schneider42/uberbus/hardware/media/alarm-innen.jpg

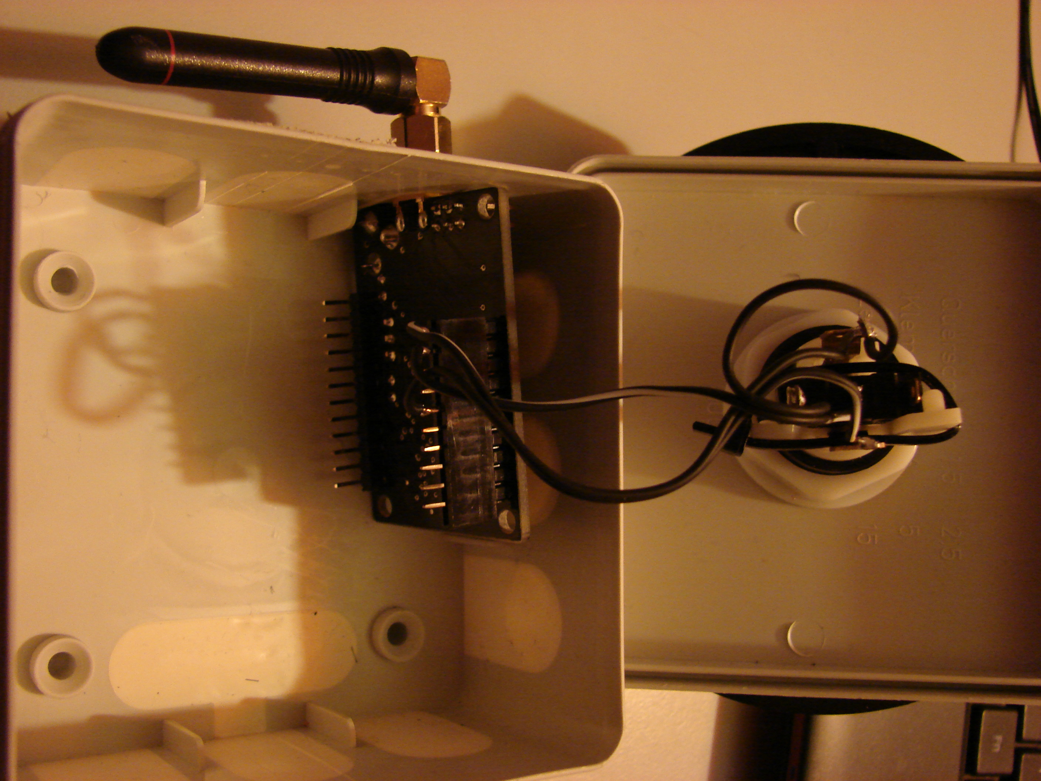
hardware/media/alarm-innen.jpg
