schneider42/uberbus/hardware/media/dev-rf-ecke.jpg

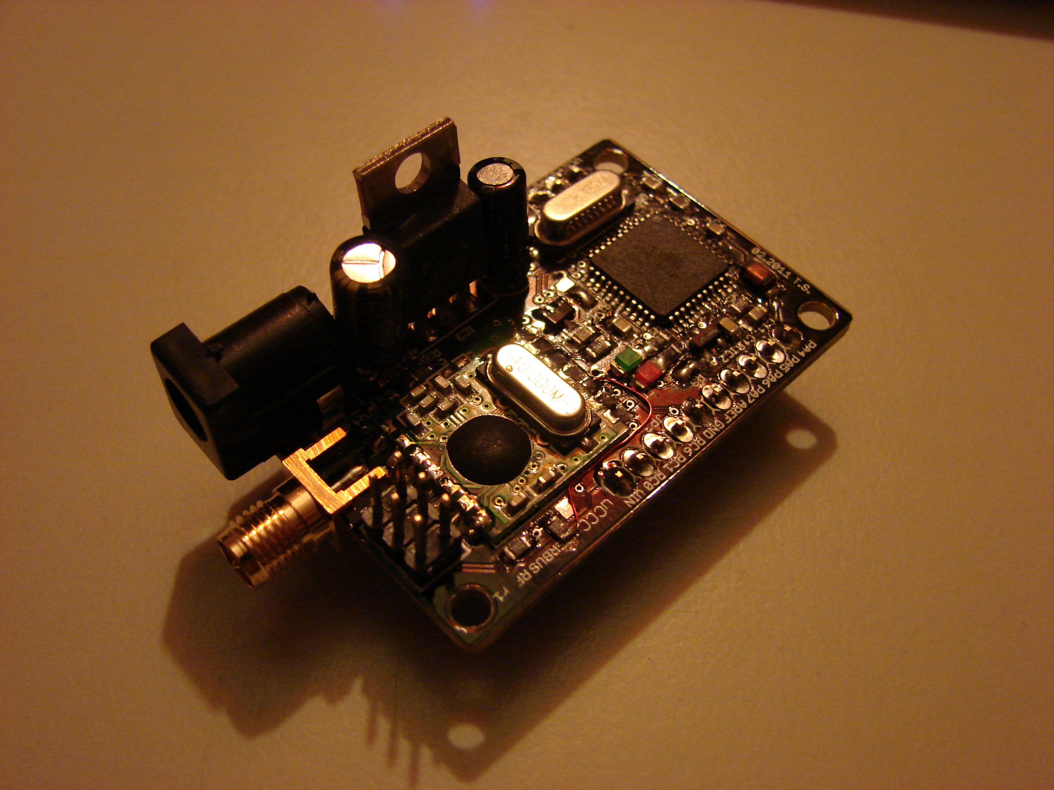
hardware/media/dev-rf-ecke.jpg
