schneider42/uberbus/software/pythonlib/doc/index.rst

.. uberbus python library documentation master file, created by
   sphinx-quickstart on Fri Mar 18 02:42:10 2011.
   You can adapt this file completely to your liking, but it should at least
   contain the root `toctree` directive.

Welcome to uberbus python library's documentation!
==================================================

Contents:

.. toctree::
   :maxdepth: 2

.. automodule:: uberbus.moodlamp

.. autoclass:: Moodlamp
          :members:

.. automodule:: uberbus.ubnode

.. autoclass:: UBNode
          :members: 

Indices and tables
==================

* :ref:`genindex`
* :ref:`modindex`
* :ref:`search`
