schneider42/uberbus/hardware/devboard/devboard-rf-brd.png

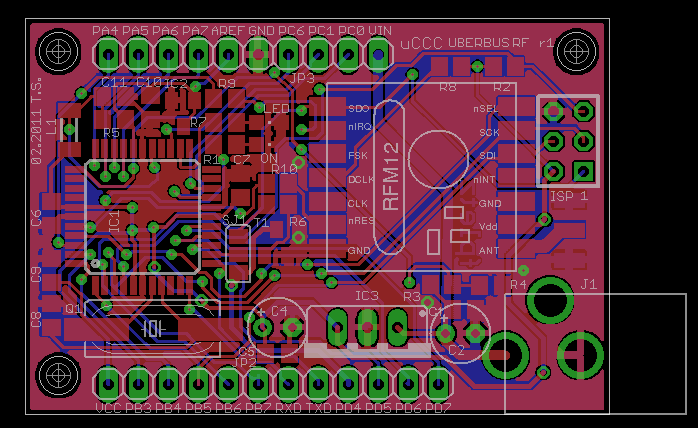
hardware/devboard/devboard-rf-brd.png
