schneider42/uberbus/hardware/devboard/devboard-rs485-brd.png

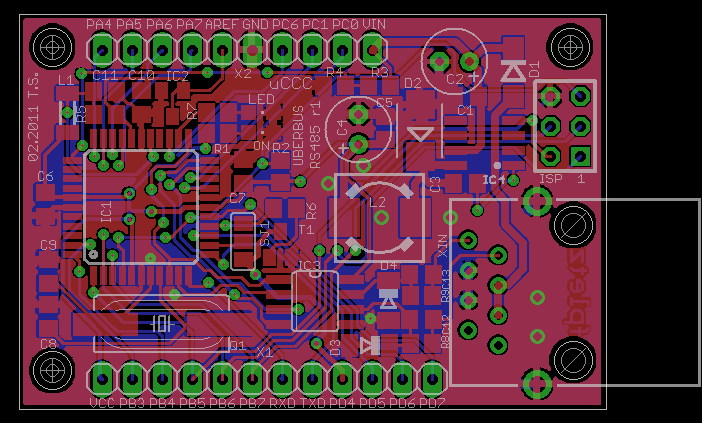
hardware/devboard/devboard-rs485-brd.png
