schneider42/uberbus/hardware/media/alarm.jpg

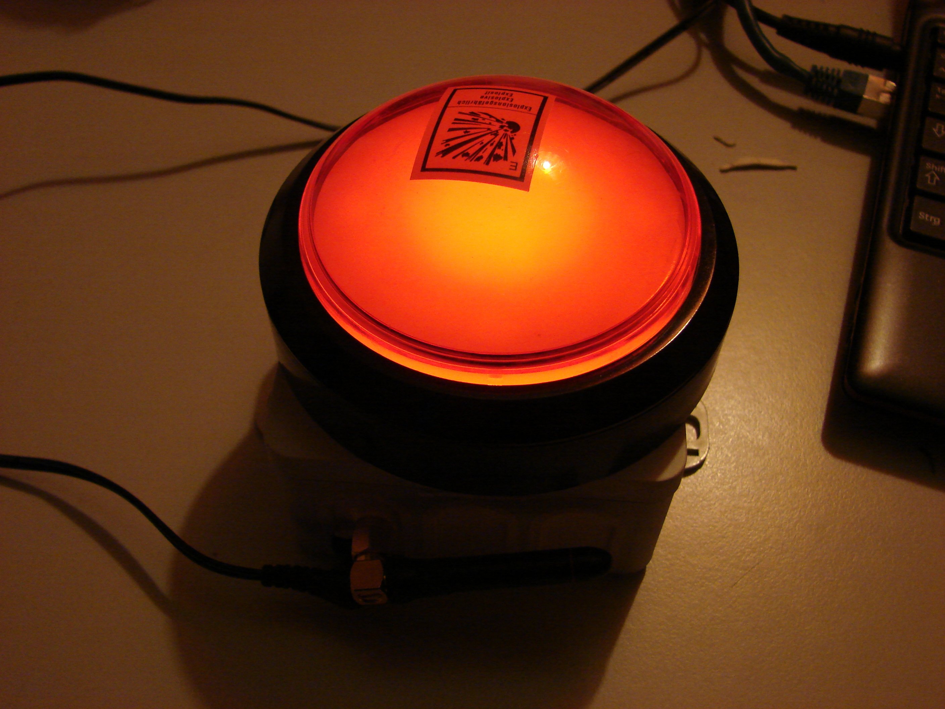
hardware/media/alarm.jpg
