schneider42/uberbus/hardware/media/dev-rf-2.jpg

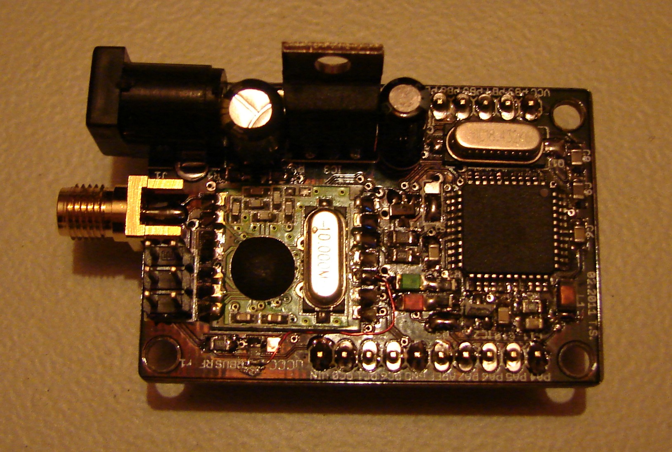
hardware/media/dev-rf-2.jpg
