schneider42/uberbus/hardware/media/dev-rf-ecke-ant.jpg

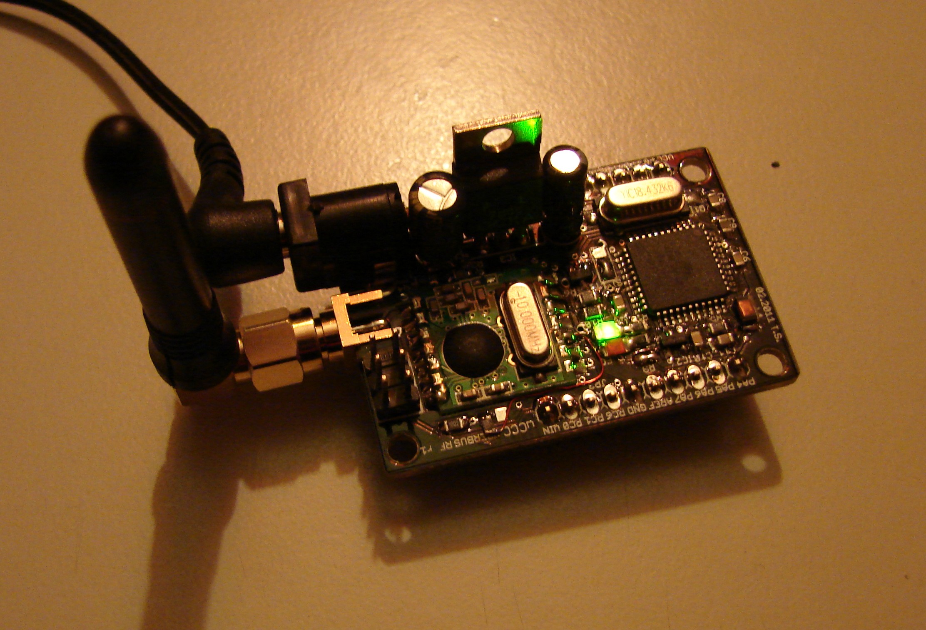
hardware/media/dev-rf-ecke-ant.jpg
