schneider42/uberbus/hardware/media/dev-rf-ecke-unten.jpg

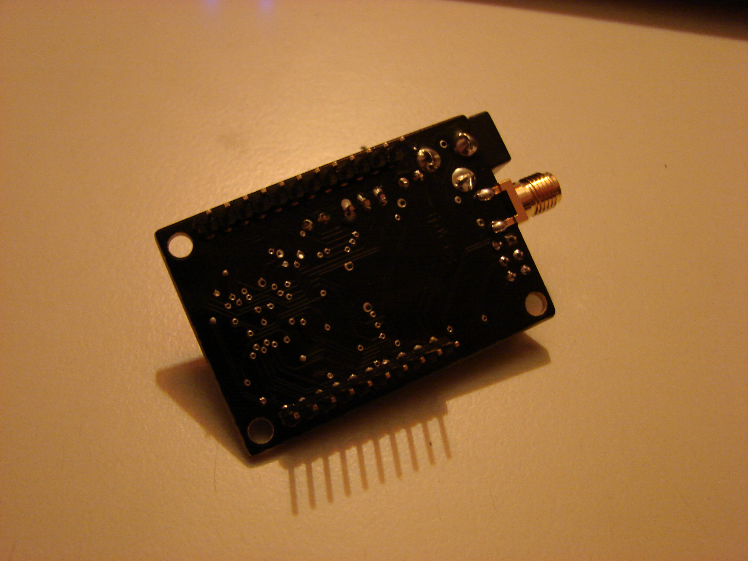
hardware/media/dev-rf-ecke-unten.jpg
