schneider42/uberbus/hardware/media/dev-rf-ml.jpg

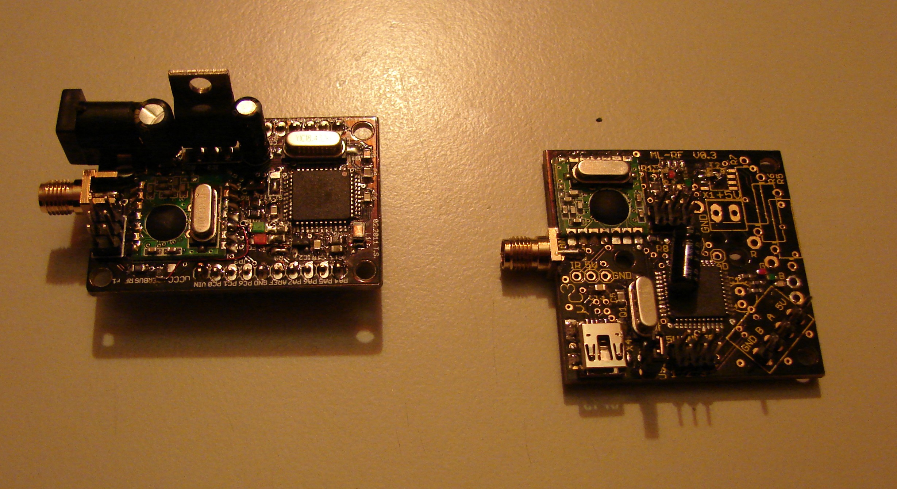
hardware/media/dev-rf-ml.jpg
