schneider42/uberbus/hardware/media/dev-rf.jpg

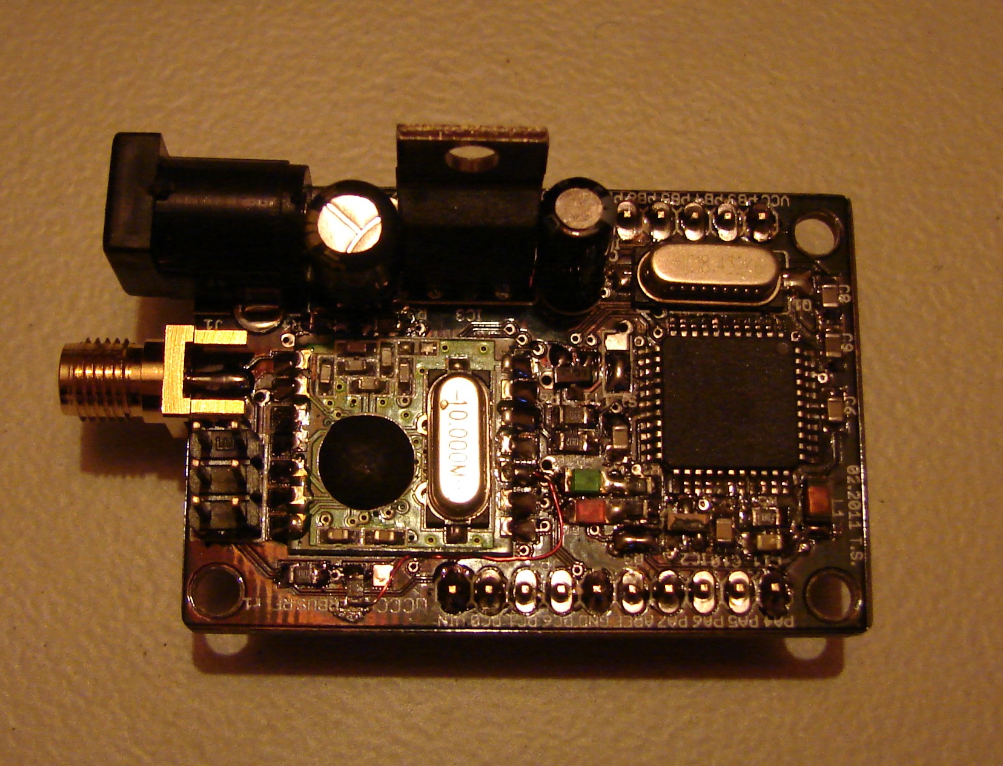
hardware/media/dev-rf.jpg
