schneider42/uberbus/hardware/media/rgb/IMG_20110629_131019.jpg

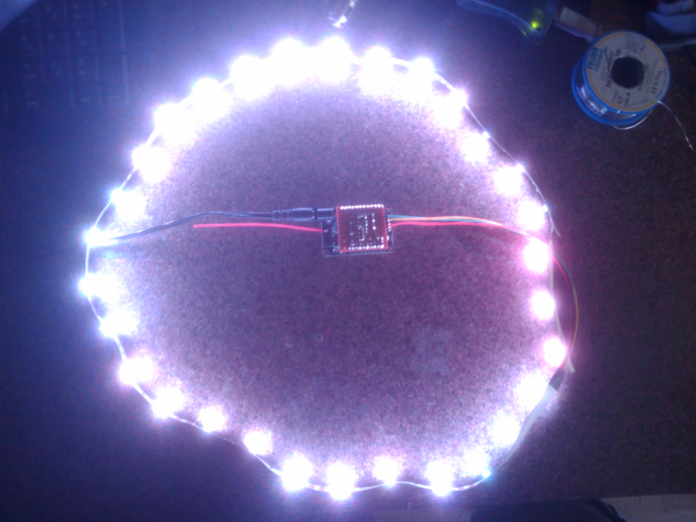
hardware/media/rgb/IMG_20110629_131019.jpg
