schneider42/uberbus/hardware/media/rgb/IMG_20110629_131027.jpg

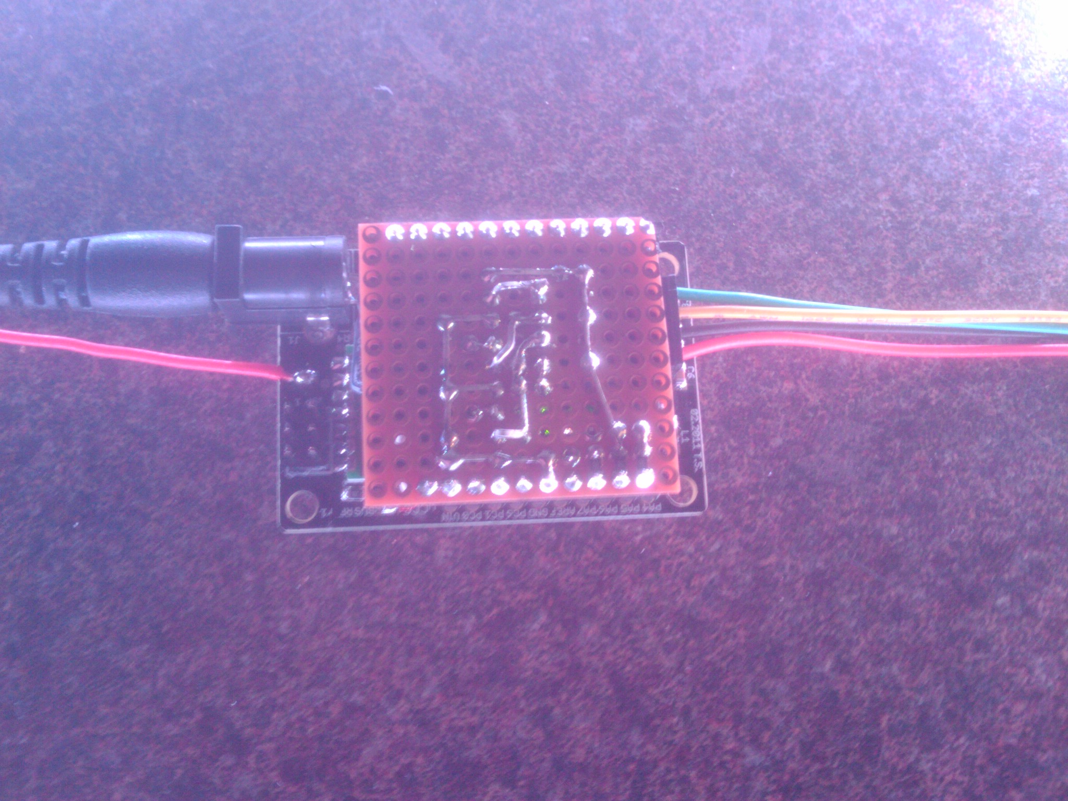
hardware/media/rgb/IMG_20110629_131027.jpg
