schneider42/uberbus/software/ubcolorgui/ml-scale.jpeg

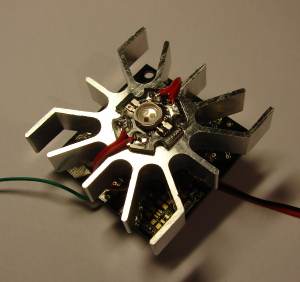
software/ubcolorgui/ml-scale.jpeg
