schneider42/uberbus/hardware/schematic_BV.pdf

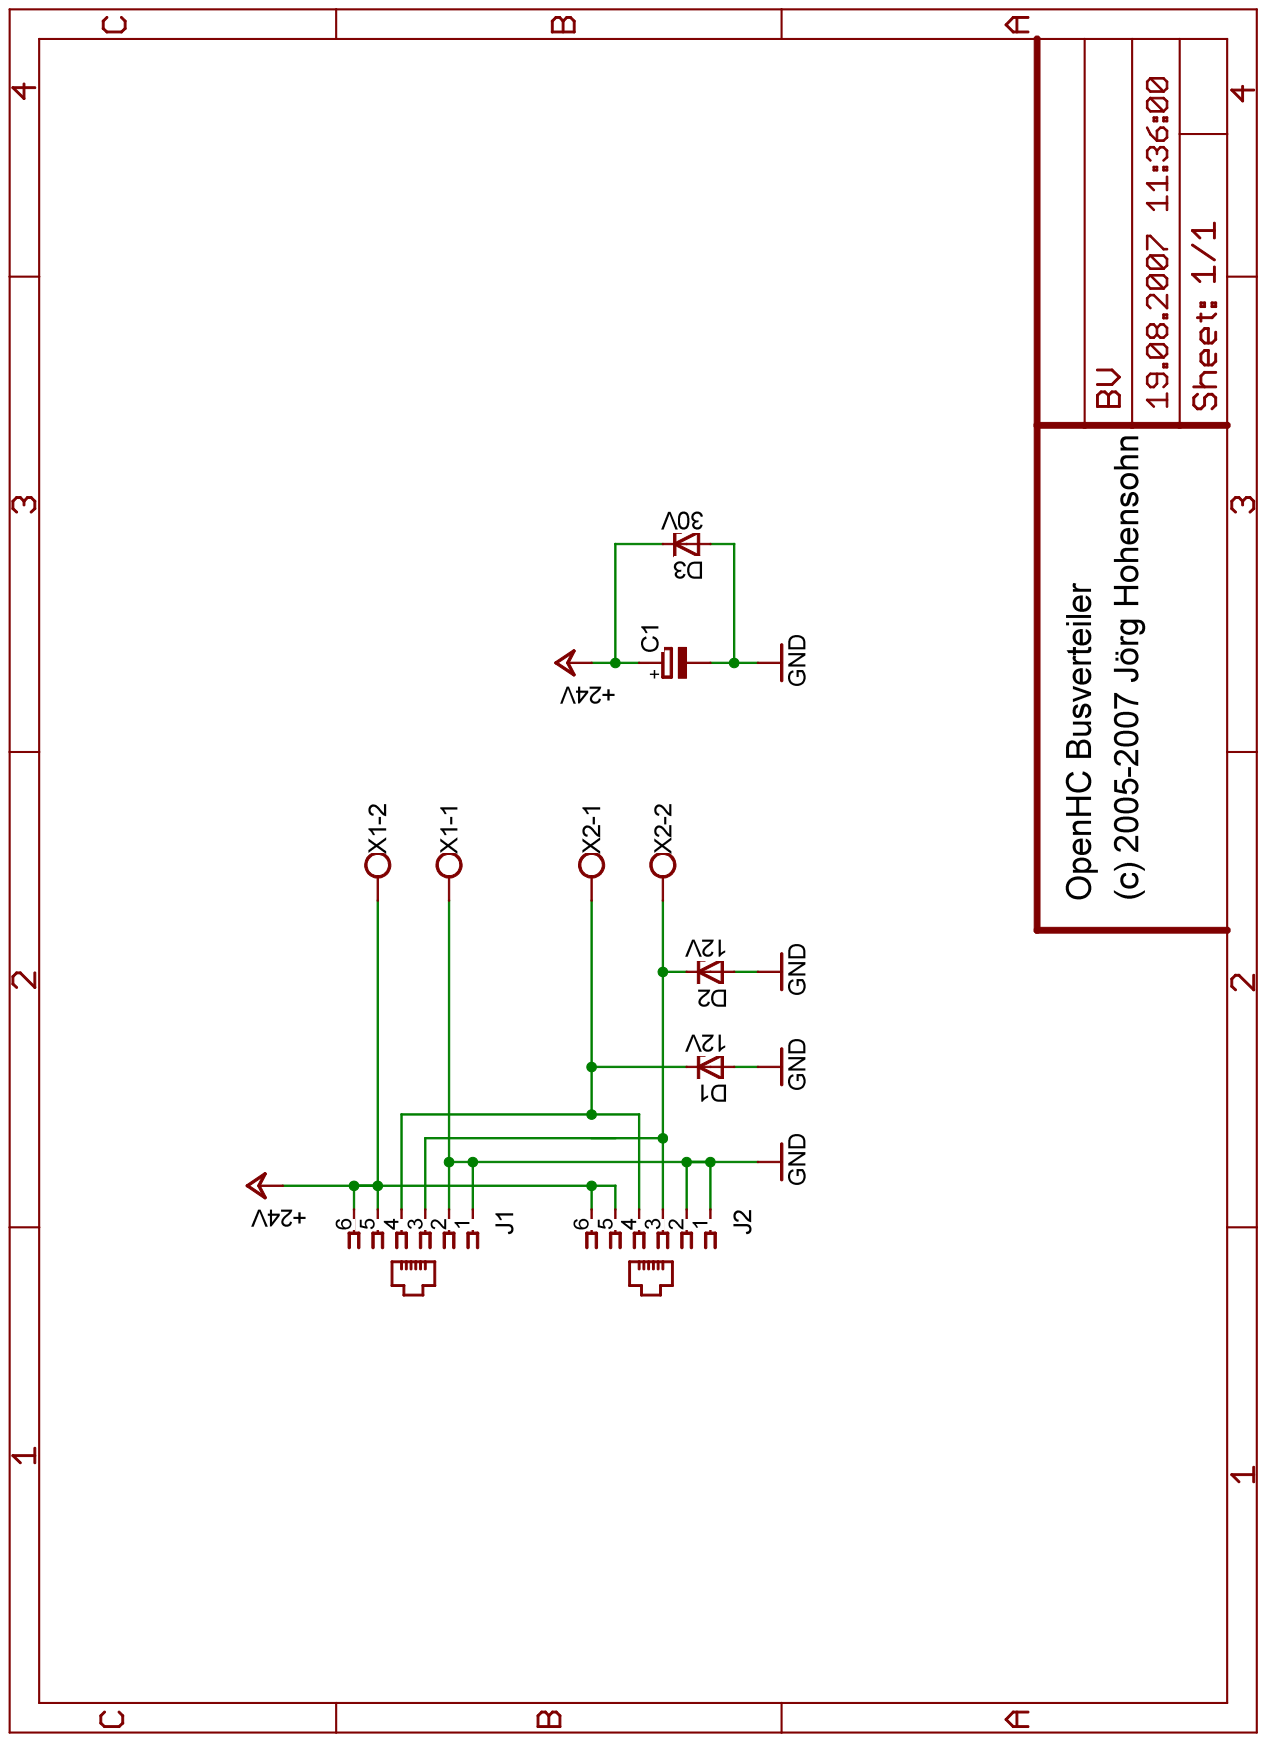
[picture p70: page 1]
