schneider42/uberbus/hardware/schematic_EM16.pdf

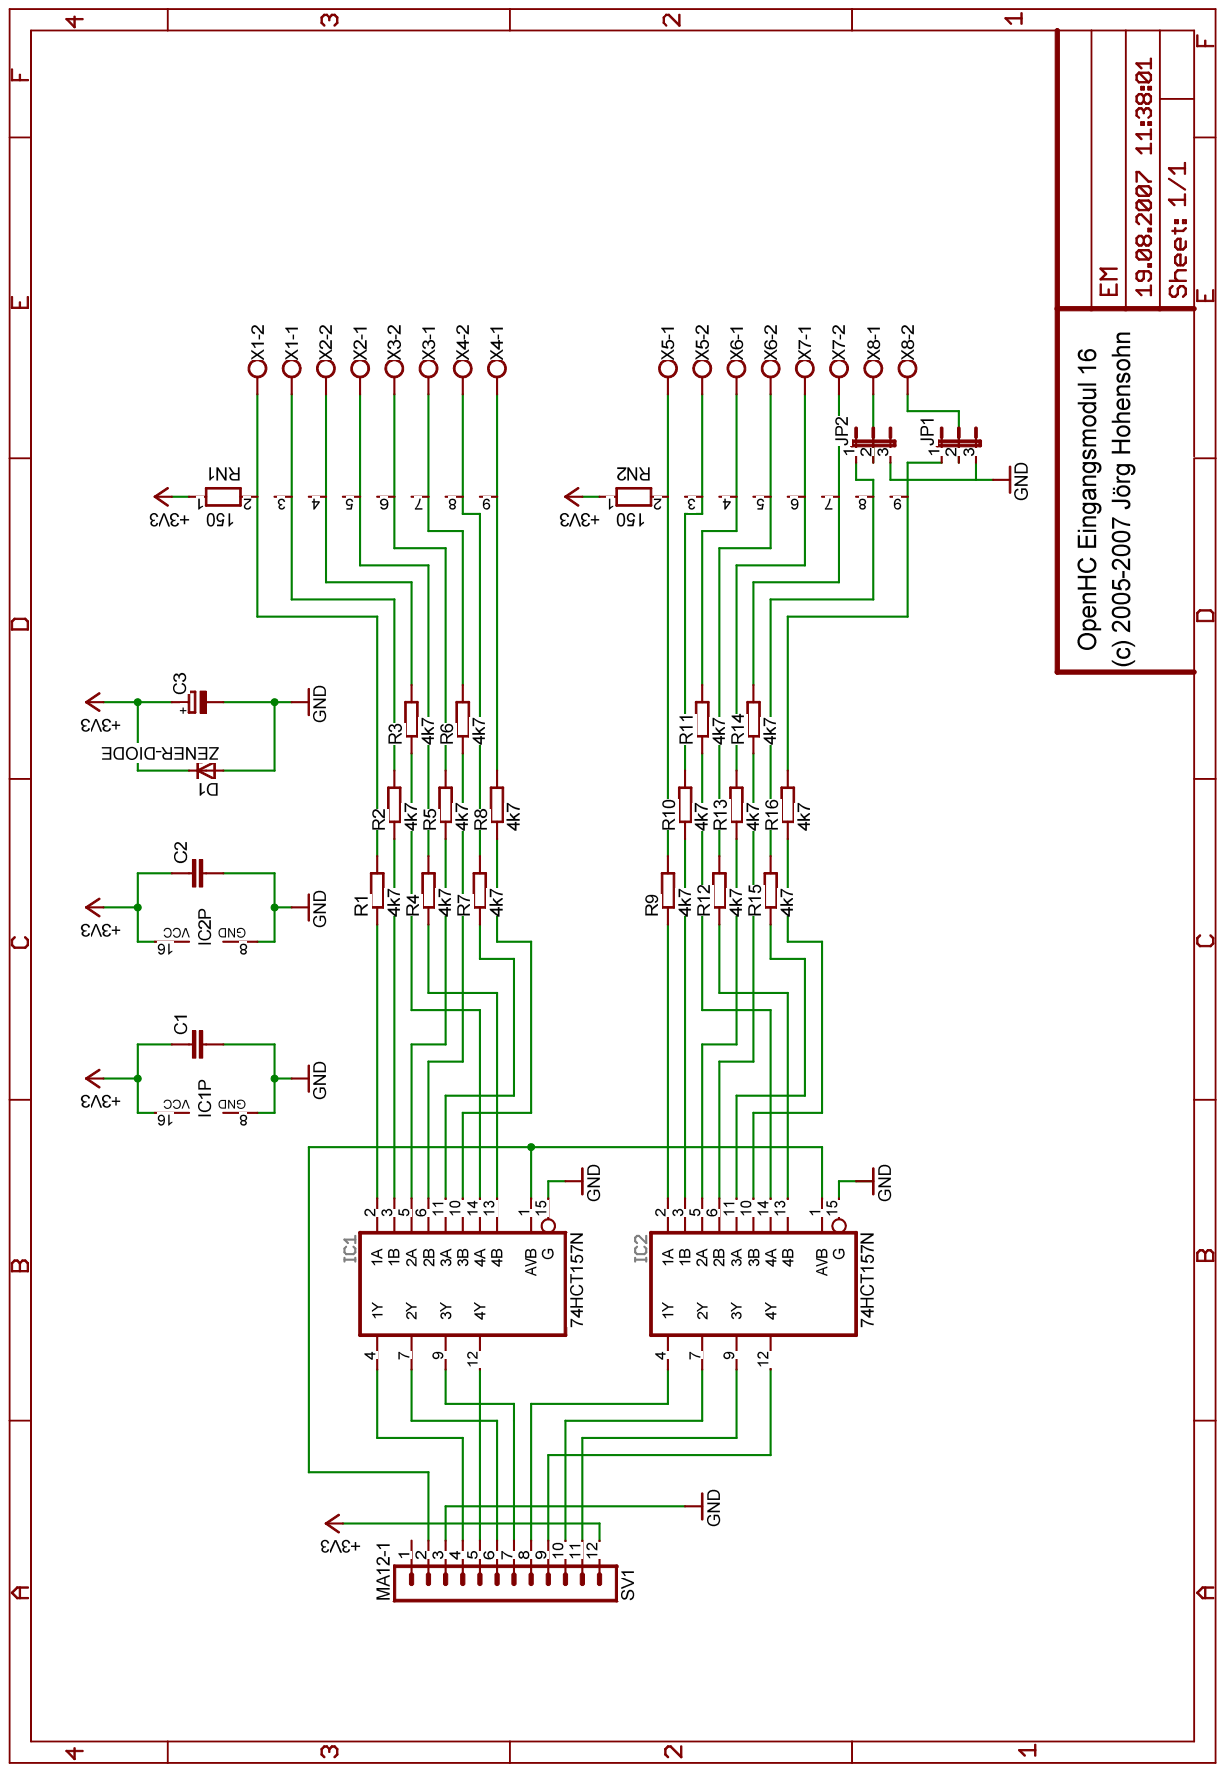
[picture p71: page 1]
