schneider42/uberbus/hardware/schematic_UEM.pdf

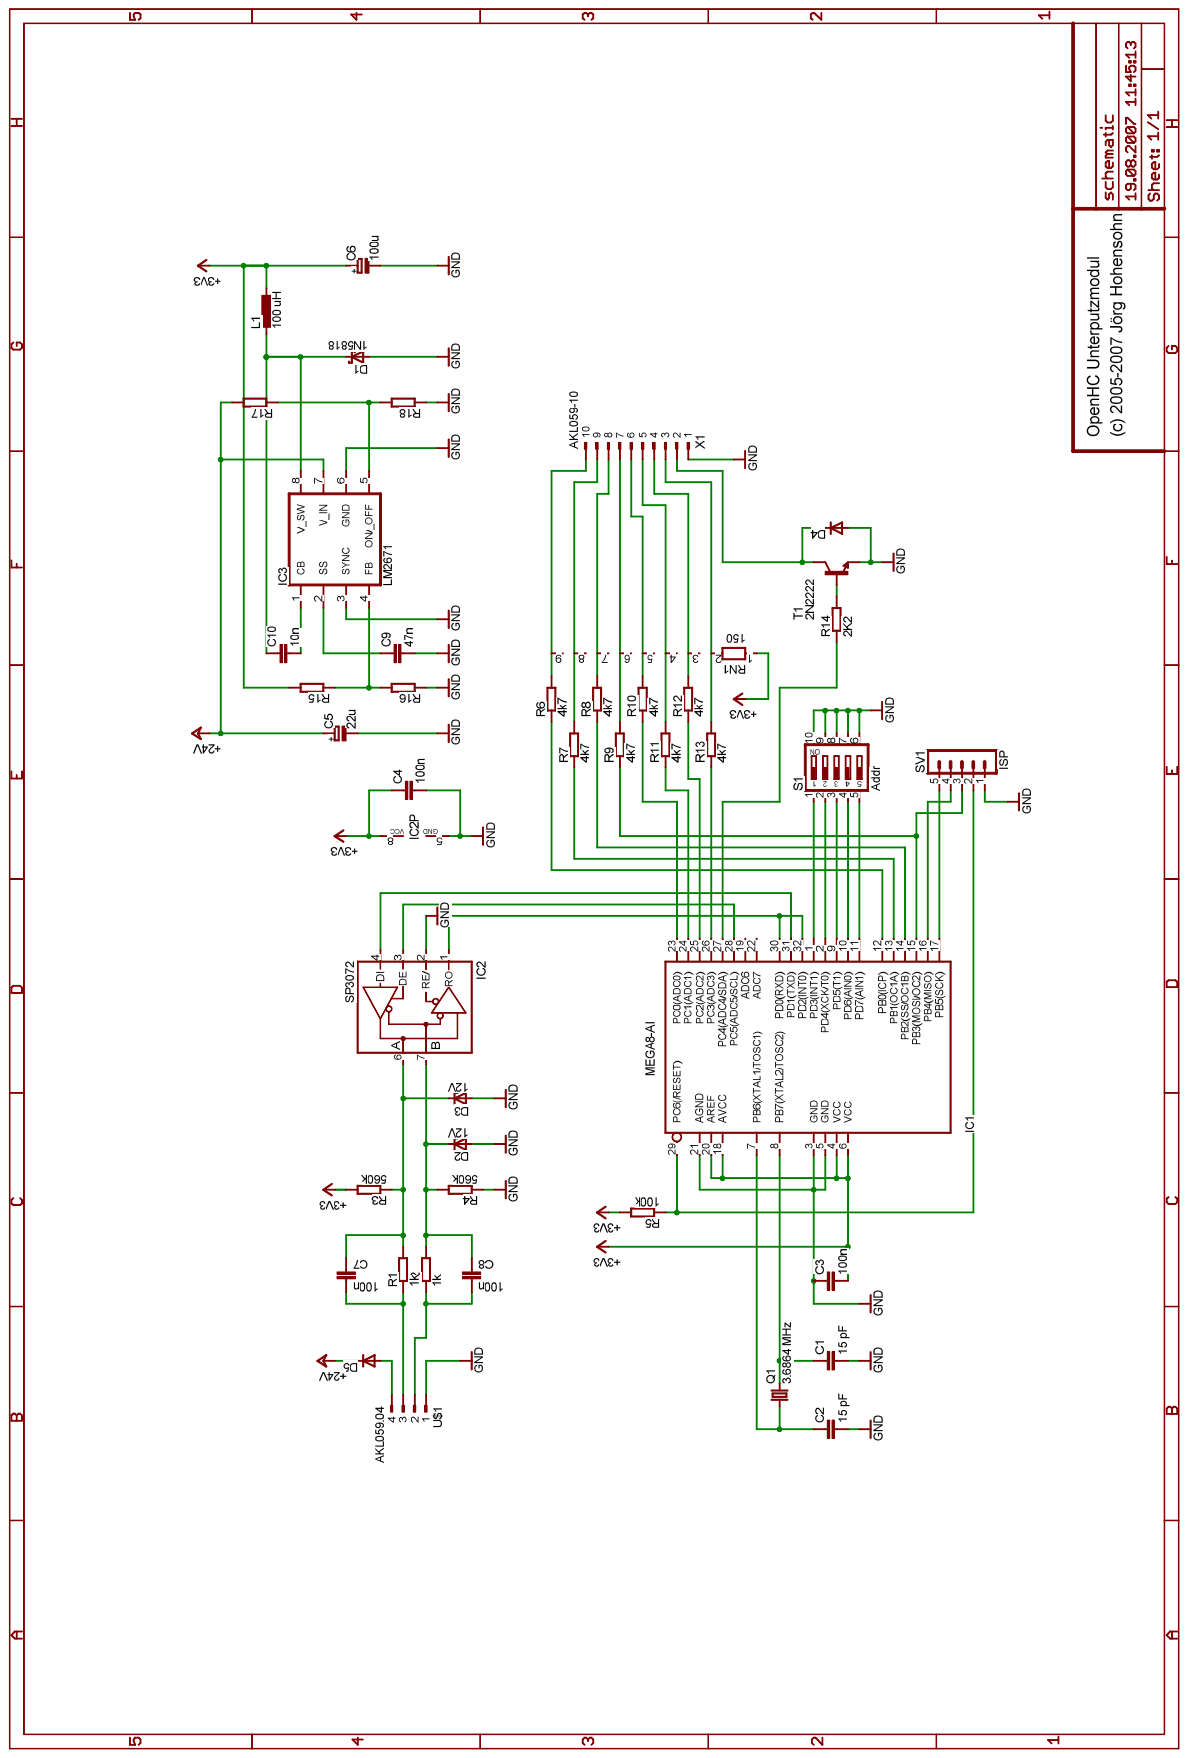
[picture p72: page 1]
