schneider42/uberbus/firmware/rgbcontroller/pwm.h

/* vim:fdm=marker ts=4 et ai
 * {{{
 *         moodlamp-ng - fnordlicht firmware next generation
 *
 *    for additional information please
 *    see http://blinkenlichts.net/
 *    and http://koeln.ccc.de/prozesse/running/fnordlicht
 *
 * This is a modified version of the fnordlicht
 * (c) by Alexander Neumann <alexander@bumpern.de>
 *     Lars Noschinski <lars@public.noschinski.de>
 *
 * Modifications done by Tobias Schneider(schneider@blinkenlichts.net)
 *
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
 * For more information on the GPL, please go to:
 * http://www.gnu.org/copyleft/gpl.html
 }}} */

#ifndef PWM_H
#define PWM_H

#include "config.h"
#include "common.h"

/* possible pwm interrupts in a pwm cycle */
#define PWM_MAX_TIMESLOTS (PWM_CHANNELS+1)

//#ifdef FAST_PWM
//#define PWM_STEPS_PER_SECOND (F_CPU/64000)
//#else
#define PWM_STEPS_PER_SECOND (F_CPU/128000)
//#endif

#define PWM_CHANNELMASK ((1<<5)|(1<<6)|(1<<7))

/* contains all the data for one color channel */
struct channel_t
/*{{{*/ {
    union {
        /* for adding fade-speed to brightness, and save the remainder */
        uint16_t brightness_and_remainder;

        /* for accessing brightness directly */
        struct {
            uint8_t remainder;
            uint8_t brightness;
        };
    };

    uint8_t brightness_scale;
    
    /* desired brightness for this channel */
    uint8_t target_brightness;
    
    #if SCRIPT_SPEED_CONTROL
//    uint16_t speed_orig;
    #endif
    
    /* fade speed, the msb is added directly to brightness,
     * the lsb is added to the remainder until an overflow happens */
    union {
        /* for accessing speed as an uint16_t */
        uint16_t speed;

        /* for accessing lsb und msb directly */
        struct {
            uint8_t speed_l;
            uint8_t speed_h;
        };
    };

    /* output mask for switching on the leds for this channel */
    uint8_t mask;
    uint8_t pinmask;

    /* flags for this channel, implemented as a bitvector field */
    struct {
        /* this channel reached has recently reached it's desired target brightness */
        uint8_t target_reached:1;
    } flags;


}; /*}}}*/

struct global_pwm_t {
    /* current channel records */
    struct channel_t channels[3];           //Darf nicht groesser 9Byte werden?
    uint8_t dim;
    uint8_t olddim;
    uint8_t channel_modifier;
    #if SCRIPT_SPEED_CONTROL
    uint8_t speed_orig[3];
    #endif
};

extern volatile struct global_pwm_t global_pwm;

/* encapsulates all pwm data including timeslot and output mask array */
struct timeslots_t
/*{{{*/ {
    struct {
        uint8_t mask;
        uint16_t top;
    } slots[PWM_MAX_TIMESLOTS];

    uint8_t index;  /* current timeslot intex in the 'slots' array */
    uint8_t count;  /* number of entries in slots */
    uint8_t next_bitmask; /* next output bitmask, or signal for start or middle of pwm cycle */
    uint8_t initial_bitmask; /* output mask set at beginning */
}; /*}}}*/

extern struct timeslots_t pwm;

/* prototypes */
void init_timer1(void);
void init_pwm(void);
void update_pwm_timeslots(void);
void update_brightness(void);

#endif
