schneider42/uberbus/software/ubd/src/busmgt.c

#include <glib.h>
#include <stdio.h>
#include <string.h>
#include <syslog.h>

#include "packet.h"
#include "ubpacket.h"
#include "debug.h"
#include "busmgt.h"
#include "mgt.h"
#include "ubconfig.h"
#include "config.h"

static void busmgt_sendReset(uint8_t adr);
static void busmgt_setQueryInterval(uint8_t adr, uint16_t interval);
static void busmgt_sendCmd(uint8_t adr, uint8_t cmd);
static void busmgt_setAddress(uint8_t adr, gchar *id);
static void busmgt_sendOK(uint8_t adr);
static void busmgt_setClasses(struct node *n, guchar *classes, int count);
static void busmgt_sendMulticastGroups(struct node *n);

void busmgt_init(void)
{
    busmgt_sendReset(UB_ADDRESS_BROADCAST);
}

gint busmgt_getFreeBusAdr()
{
    int i;
    for(i=3; i<255; i++){
        if( nodes_getNodeByBusAdr(i) == NULL )
            return i;
    }
    syslog(LOG_WARNING,"busmgt.c: warning: found no free address!\n");
    return -1;
}

void busmgt_inpacket(struct ubpacket* p)
{
    //TODO: check len of id buffer
    gchar id[100];
    guchar classes[4];
    struct node * n;
    uint16_t interval;


    switch(p->data[0]){
        //A new node tries to get an address
        case 'D':
            interval = (p->data[1]<<8) + p->data[2];
            if( p->len > sizeof(id) )
                return;
            memcpy(classes, p->data+3, 4);
            memcpy(id, p->data+7, p->len-7);
            id[p->len-7] = 0;

            syslog(LOG_INFO,"busmgt: got discover from %s\n", id);

            //n = nodes_getNodeById(id);
            //if( n == NULL ){
                syslog(LOG_DEBUG,"busmgt: creating new node\n");
                n = mgt_createNode(TYPE_NODE, id);
                if( n == NULL){
                    syslog(LOG_WARNING,"busmgt: no free nodes available. please wait.\n");
                    return;
                }
                ub_assert(n->busadr != 0);
                syslog(LOG_DEBUG,"busmgt: new bus address: %u\n",n->busadr);
            //}else{
            //    syslog(LOG_DEBUG,"busmgt: old bus address: %u\n",n->busadr);
            //}

            //TODO: check if it is possible for the bus to query
            //the node at this interval
            busmgt_setClasses(n, classes, sizeof(classes));
            busmgt_setQueryInterval(n->busadr, interval);
            busmgt_setAddress(n->busadr, id);
            n->state = NODE_IDENTIFY;
            n->timeout = config.nodetimeout;
        break;
        
        //The node confirms an address
        case 'I':
            //TODO:log error
            if( sizeof(id) < p->len )
                return;
            memcpy(id, p->data+1, p->len-1);
            id[p->len-1] = 0;
            syslog(LOG_INFO,"busmgt: got identify from %s\n", id);

            n = nodes_getNodeById(id);
            if( n == NULL ){
                syslog(LOG_WARNING,"busmgt: unkown node\n");
                busmgt_sendReset(p->src);
                return;
            }
            //send the OK if we have our interface ready
            if( n->netup == TRUE){
                syslog(LOG_DEBUG,"busmgt: node known\n");
                busmgt_sendMulticastGroups(n);
                busmgt_sendOK(p->src);
                //n->state = NODE_IDENTIFY;
                n->state = NODE_NORMAL;
                n->timeout = config.nodetimeout;
                n->busup = TRUE;
                nodes_activateNode(n);
            }else{
                syslog(LOG_INFO,"IPv6 interface not up yet\n");
            }

        break;
        case 'V':
            n = nodes_getNodeByBusAdr(p->src);
            //TODO: check len of p->data
            memcpy(n->version, p->data+2, p->len-2);
        break;
        //a keep alive packet
        case 'A':
            n = nodes_getNodeByBusAdr(p->src);
            if( n == NULL ){
                busmgt_sendReset(p->src);
                return;
            }
            //reset the timeout
            n->timeout = config.nodetimeout;
        break;
        //the bridge id
        case 'B':
            //TODO: check len of p->data
            memcpy(classes, p->data+1, 4);
            memcpy(id, p->data+5, p->len-5);
            id[p->len-5] = 0;
            syslog(LOG_INFO,"busmgt: bridge id %s\n", id);
            mgt_createBridge(id);
            n = nodes_getNodeByBusAdr(p->src);

            syslog(LOG_DEBUG,"bus addr of new node is %d\n",n->busadr);
            busmgt_setClasses(n, classes, sizeof(classes));
            busmgt_sendMulticastGroups(n);
            busmgt_sendOK(p->src);
            n->state = NODE_NORMAL;
            n->timeout = config.nodetimeout;
            n->busup = TRUE;
            syslog(LOG_INFO,"bus is up\n");
        break;
    };
}

//add an address to a multicast group
void busmgt_addToMulticast(uint8_t adr, uint8_t mcast)
{
    syslog(LOG_INFO,"Adding node %d to multicast group %d\n",adr,mcast);
    uint8_t data[] = {mcast};
    busmgt_sendCmdData(adr,'1',data,sizeof(data));
}

void busmgt_setName(uint8_t adr, char *name)
{
    syslog(LOG_DEBUG,"Setting name of %u to %s\n",adr,name);
    //include the trailing 0
    busmgt_sendCmdData(adr,'s',(uint8_t*)name,strlen(name)+1);
}

static void busmgt_sendReset(uint8_t adr)
{
    syslog(LOG_INFO,"Sending reset to %u\n", adr);
    struct ubpacket p;
    p.dest = adr;
    p.len = 1;
    p.data[0] = 'r';
    //don't expect an ack for a reset
    p.flags = UB_PACKET_MGT | UB_PACKET_NOACK;
    packet_outpacket(&p);
}

static void busmgt_setQueryInterval(uint8_t adr, uint16_t interval)
{
    syslog(LOG_DEBUG,"Setting query interval of %u to %u\n", adr,interval);
    uint8_t data[] = {adr,interval>>8,interval&0xFF};
    busmgt_sendCmdData(UB_ADDRESS_BRIDGE,'q',data,sizeof(data));
}

static void busmgt_setClasses(struct node *n, guchar *classes, int count)
{
    memset(n->classes,0,sizeof(n->classes));
    memcpy(n->classes, classes, count);
}

//send a broadcast to set the address of the node with name '*id'
static void busmgt_setAddress(uint8_t adr, gchar *id)
{
    uint8_t data[strlen(id)+2];
    data[0] = adr;
    strcpy((char*)data+1, id);
    busmgt_sendCmdData(UB_ADDRESS_BROADCAST,'S',data,sizeof(data));
}

//send an OK to the address and request the software version
static void busmgt_sendOK(uint8_t adr)
{
    syslog(LOG_DEBUG,"Sending OK to %u\n",adr);
    busmgt_sendCmd(adr,'O');

    syslog(LOG_DEBUG,"Getting version from  %u\n",adr);
    busmgt_sendCmd(adr,'V');

}

static void busmgt_sendMulticastGroups(struct node *n)
{
    int i;
    syslog(LOG_DEBUG,"sending multicast groups\n");
    for(i=0; i<32; i++){
        if( n->groups[i] != -1 ){
            syslog(LOG_DEBUG,"adding multicast address %d\n",n->groups[i]);
            uint8_t d = n->groups[i];
            busmgt_sendCmdData(n->busadr,'A',&d,1);
        }
    }
}

//send a command without any data
static void busmgt_sendCmd(uint8_t adr, uint8_t cmd)
{
    busmgt_sendCmdData(adr,cmd,NULL,0);
}

//send a command with attaches data
void busmgt_sendCmdData(uint8_t adr, uint8_t cmd,
                                uint8_t *data, uint8_t len)
{
    struct ubpacket p;
    p.dest = adr;
    p.len = len+1;
    p.data[0] = cmd;

    if( p.len > sizeof(p.data)){
        syslog(LOG_WARNING,"busmgt_sendCmdData(): packet to big!\n");
        //TODO: log and report this error.
        return;
    }

    while(len--)
        p.data[len+1] = data[len];

    p.flags = UB_PACKET_MGT;

    packet_outpacket(&p);
}

void busmgt_streamData(struct node *n, guchar *buf, gint len,
                UBSTREAM_CALLBACK callback, gpointer data)
{
    struct ubpacket packet;
    packet.dest = n->busadr;
    packet.len = len;
    if( packet.len > sizeof(packet.data)){
        syslog(LOG_WARNING,"busmgt_sendCmdData(): packet to big!\n");
        //TODO: log this error
        //TODO: fragment packet?
        return;
    }
    packet.flags = UB_PACKET_MGT;
    memcpy(packet.data, buf, len);
    packet_streamPacket(n, &packet, callback, data);
}
