schneider42/uberbus/software/ubd/src/address6.c

#include <glib.h>
#include <gio/gio.h>
#include <stdio.h>
#include <syslog.h>

#include "address6.h"
#include "address6db.h"
#include "net.h"
#include "interface.h"
#include "mgt.h"
#include "avahi.h"
#include "debug.h"

void address6_init(GInetAddress *base, GInetAddress *multicastbase)
{
    address6db_init(base, multicastbase);
}

/*
 * Tries to add a new address to the interface.
 * If there is already an address for this ID
 * no new address will be created.
 * Parameter: id
 * Returns: 0 on success, -1 on error
*/

void address6_createAddress(struct node *n)
{
    syslog(LOG_INFO,"adding address for %s\n",n->id);
    if( n->netadr == NULL ){
        n->netadr = address6db_getFreeAddr(n->id);
	ub_assert(n->netadr);
    }
    avahi_removeNode(n);
    interface_removeAddress(n);
    avahi_registerNode(n);
    interface_createAddress(n);
}

void address6_removeAddress(struct node *n)
{
   avahi_removeNode(n);
   interface_removeAddress(n);
}
