schneider42/uberbus/software/ubd/src/address6db.c

#include <stdio.h>
#include <glib.h>
#include <gio/gio.h>
#include <syslog.h>
#include "address6db.h"
#include "nodes.h"
#include "debug.h"

GInetAddress *baseaddress;
GInetAddress *multicastbaseaddress;

void address6db_init(GInetAddress *base, GInetAddress *multicastbase)
{
    ub_assert(base);
    ub_assert(multicastbase);
    baseaddress = g_inet_address_new_from_bytes(
                    g_inet_address_to_bytes(base),
                    G_SOCKET_FAMILY_IPV6);
    multicastbaseaddress = g_inet_address_new_from_bytes(
                    g_inet_address_to_bytes(multicastbase),
                    G_SOCKET_FAMILY_IPV6);
}
#if 0
gboolean db_isIPKnown(GInetAddress *addr)
{
    int i;
    gchar *tmp = g_inet_address_to_string(addr);
    gint count = nodes_getNodeCount();
    for(i=0;i<count;i++){
        struct node *n = nodes_getNode(i);
        syslog(LOG_DEBUG,"checking node %d\n",i);
        if( n->netadr != NULL ){
            //syslog(LOG_DEBUG,"found used ip\n");
            if( memcmp( g_inet_address_to_bytes(n->netadr),
                g_inet_address_to_bytes(addr),16) == 0 ){
                syslog(LOG_DEBUG,"ip %s used by node %s\n",tmp,n->id);
                g_free(tmp);
                return TRUE;
            }
        }
    }
    syslog(LOG_DEBUG,"ip %s unknown\n",tmp);
    g_free(tmp);
    return FALSE;
}
#endif

GInetAddress *address6db_getFreeAddr(gchar *id)
{
    guint8 addrbuf[16];
    GInetAddress *addr;

    memcpy(addrbuf,(guint8*) g_inet_address_to_bytes(baseaddress),16);
    
    GChecksum* checksum = g_checksum_new(G_CHECKSUM_MD5);
    g_checksum_update(checksum, (guchar*)id, strlen(id));

    guint8 digest[128];
    gsize size = 128;

    g_checksum_get_digest(checksum, digest, &size);
    g_checksum_free(checksum);

    memcpy(addrbuf+8,digest,8);

    addr = g_inet_address_new_from_bytes(addrbuf,G_SOCKET_FAMILY_IPV6);
    
    gchar *tmp = g_inet_address_to_string(addr);
    syslog(LOG_DEBUG,"using address: %s\n",tmp);
    g_free(tmp);
    return addr;
}

GInetAddress* address6db_getMulticastAddr(gchar *groupname){
    guint8 addrbuf[16];
    GInetAddress *addr;

    memcpy(addrbuf,(guint8*) g_inet_address_to_bytes(multicastbaseaddress),16);
    
    GChecksum* checksum = g_checksum_new(G_CHECKSUM_MD5);
    g_checksum_update(checksum, (guchar*)groupname, strlen(groupname));

    guint8 digest[128];
    gsize size = 128;

    g_checksum_get_digest(checksum, digest, &size);
    g_checksum_free(checksum);

    memcpy(addrbuf+2,digest,14);

    addr = g_inet_address_new_from_bytes(addrbuf,G_SOCKET_FAMILY_IPV6);
    
    gchar *tmp = g_inet_address_to_string(addr);
    syslog(LOG_DEBUG,"using address: %s\n",tmp);
    g_free(tmp);
    return addr;
}
