schneider42/uberbus/software/ubd/src/net_multicast.c

#include <stdint.h>
#include <stdio.h>
#include <string.h>
#include <stdlib.h>
#include <glib.h>
#include <gio/gio.h>
#include <net/if.h>
#include <netinet/in.h>
#include <sys/types.h>
#include <sys/socket.h>
#include <netdb.h>
#include <syslog.h>

#include "address6db.h"
#include "config.h"
#include "debug.h"

GSocket *multicast_createSocket(gchar *groupname, guint port,
                                 GSocketAddress **sa)
{
    GError *err = NULL;
    GInetAddress *addr = address6db_getMulticastAddr(groupname);
    *sa = g_inet_socket_address_new(addr,port);

    GSocket *socket = g_socket_new(G_SOCKET_FAMILY_IPV6,
                        G_SOCKET_TYPE_DATAGRAM,
                        G_SOCKET_PROTOCOL_UDP,
                        NULL);
    ub_assert(socket != NULL);

    if( g_socket_bind(socket, *sa, TRUE, &err) == FALSE ){
        syslog(LOG_ERR, "net_createSockets: Error while binding udp socket: %s\n", err->message);
        g_error_free(err);
        g_object_unref(*sa);
        g_object_unref(socket);
        return NULL;
    }

    struct addrinfo *resmulti;
    struct ipv6_mreq mreq;
    mreq.ipv6mr_interface = if_nametoindex(config.interface);
    gchar *tmp = g_inet_address_to_string(addr);
    syslog(LOG_DEBUG,"using address: %s\n",tmp);
    getaddrinfo(tmp, NULL, NULL, &resmulti);
    g_free(tmp);
    mreq.ipv6mr_multiaddr = ((struct sockaddr_in6 *)resmulti->ai_addr)->sin6_addr;
    setsockopt(g_socket_get_fd(socket), IPPROTO_IPV6,
        IPV6_ADD_MEMBERSHIP, (char *)&mreq, sizeof(mreq));
    return socket;
}
