schneider42/uberbus/software/ubd/src/net.h

#ifndef __NET6_H__
#define __NET6_H__
#include <glib.h>
#include "mgt.h"

#include "nodes.h"

gint net_init(gchar* interface, gchar* baseaddress, gchar *multicastbase);
void net_createSockets(struct node *n);
void net_removeSockets(struct node *n);

#endif
