schneider42/uberbus/(commit log)

2011-02-14 added devboard files
    [devboard.brd, devboard.sch]
2011-02-14 new inductor and switcher
    [devboard.brd, devboard.sch]
2011-02-16 new components, some airwires, new dimensions
    [devboard.brd, devboard.sch]
2011-02-18 design study
    [devboard.brd, devboard.sch]
2011-02-25 added separate boards for rs485 and rf
    [devboard-rf.brd, devboard-rf.sch, devboard-rs485.brd, devboard-rs485.sch, devboard.brd, devboard.sch]
2011-02-25 silk screen
    [devboard-rs485.brd]
2011-02-25 finished designs
    [devboard-rf.brd, devboard-rf.sch, devboard-rs485.brd, devboard-rs485.sch]
2011-02-26 changed drill size to 0.4mm added uCCC and fpletz
    [devboard-rf.brd, devboard-rs485.brd]
2011-02-27 silk screen update
    [devboard-rf.brd, devboard-rs485.brd, devboard-rs485.sch]
2011-02-27 let the booloader be able to reset the rs485bridge
    [launcher.py, serialinterface.py]
2011-02-27 current reset command
2011-02-27 bug fix for serial interface
    [serialinterface.py]
2011-02-27 removed old oll in one board
    [devboard.brd, devboard.sch]
2011-03-03 new reset command correct escaping for ubloader
    [flash.py, serialinterface.py]
2011-03-05 correct len checks for groups.c
    [groups.c]
2011-03-05 fixed printf
2011-03-07 use correct address for multicast group
    [net_multicast.c]
2011-03-08 new switch port
2011-03-12 added command to read current color
2011-03-21 increased pwm frequency from 144Hz to 288Hz decreased pwm resolution from 17Bit to 16Bit
2011-03-22 disabled leds
2011-03-23 moved tx/rx leds into lib
2011-03-24 added "error handling" in switchsiren
2011-03-26 sniffer: also print string
2011-03-27 pythonlib: switch: added commands to set/clear pins
2011-03-28 ubd: write pid file
2011-03-29 ubd: fix rlimit for core dumps
    [segfault.c]
2011-04-01 ubd: listen in correct socket
    [net_tcp.c]
2011-06-23 better interrupt handling
2011-06-23 added test code for the rf board
2011-06-23 configure external interrupt in project
2011-06-23 hid: configure external interrupt
2011-07-03 fixed error in di struct
    [digitalinput.c]
2011-07-03 removed adc dep
2011-07-03 added some values for the rs485 board
    [devboard-rs485.brd, devboard-rs485.sch]
