schneider42/uberbus/(notices)

Notices in the files:
firmware/rgbcontroller/settings.c:
This program is free software; you can redistribute it and/or modify
it under the terms of the GNU General Public License version 2 as
published by the Free Software Foundation.
